cvra/VL53L0X-tof-sensor-board/tof-sensor-board.pdf

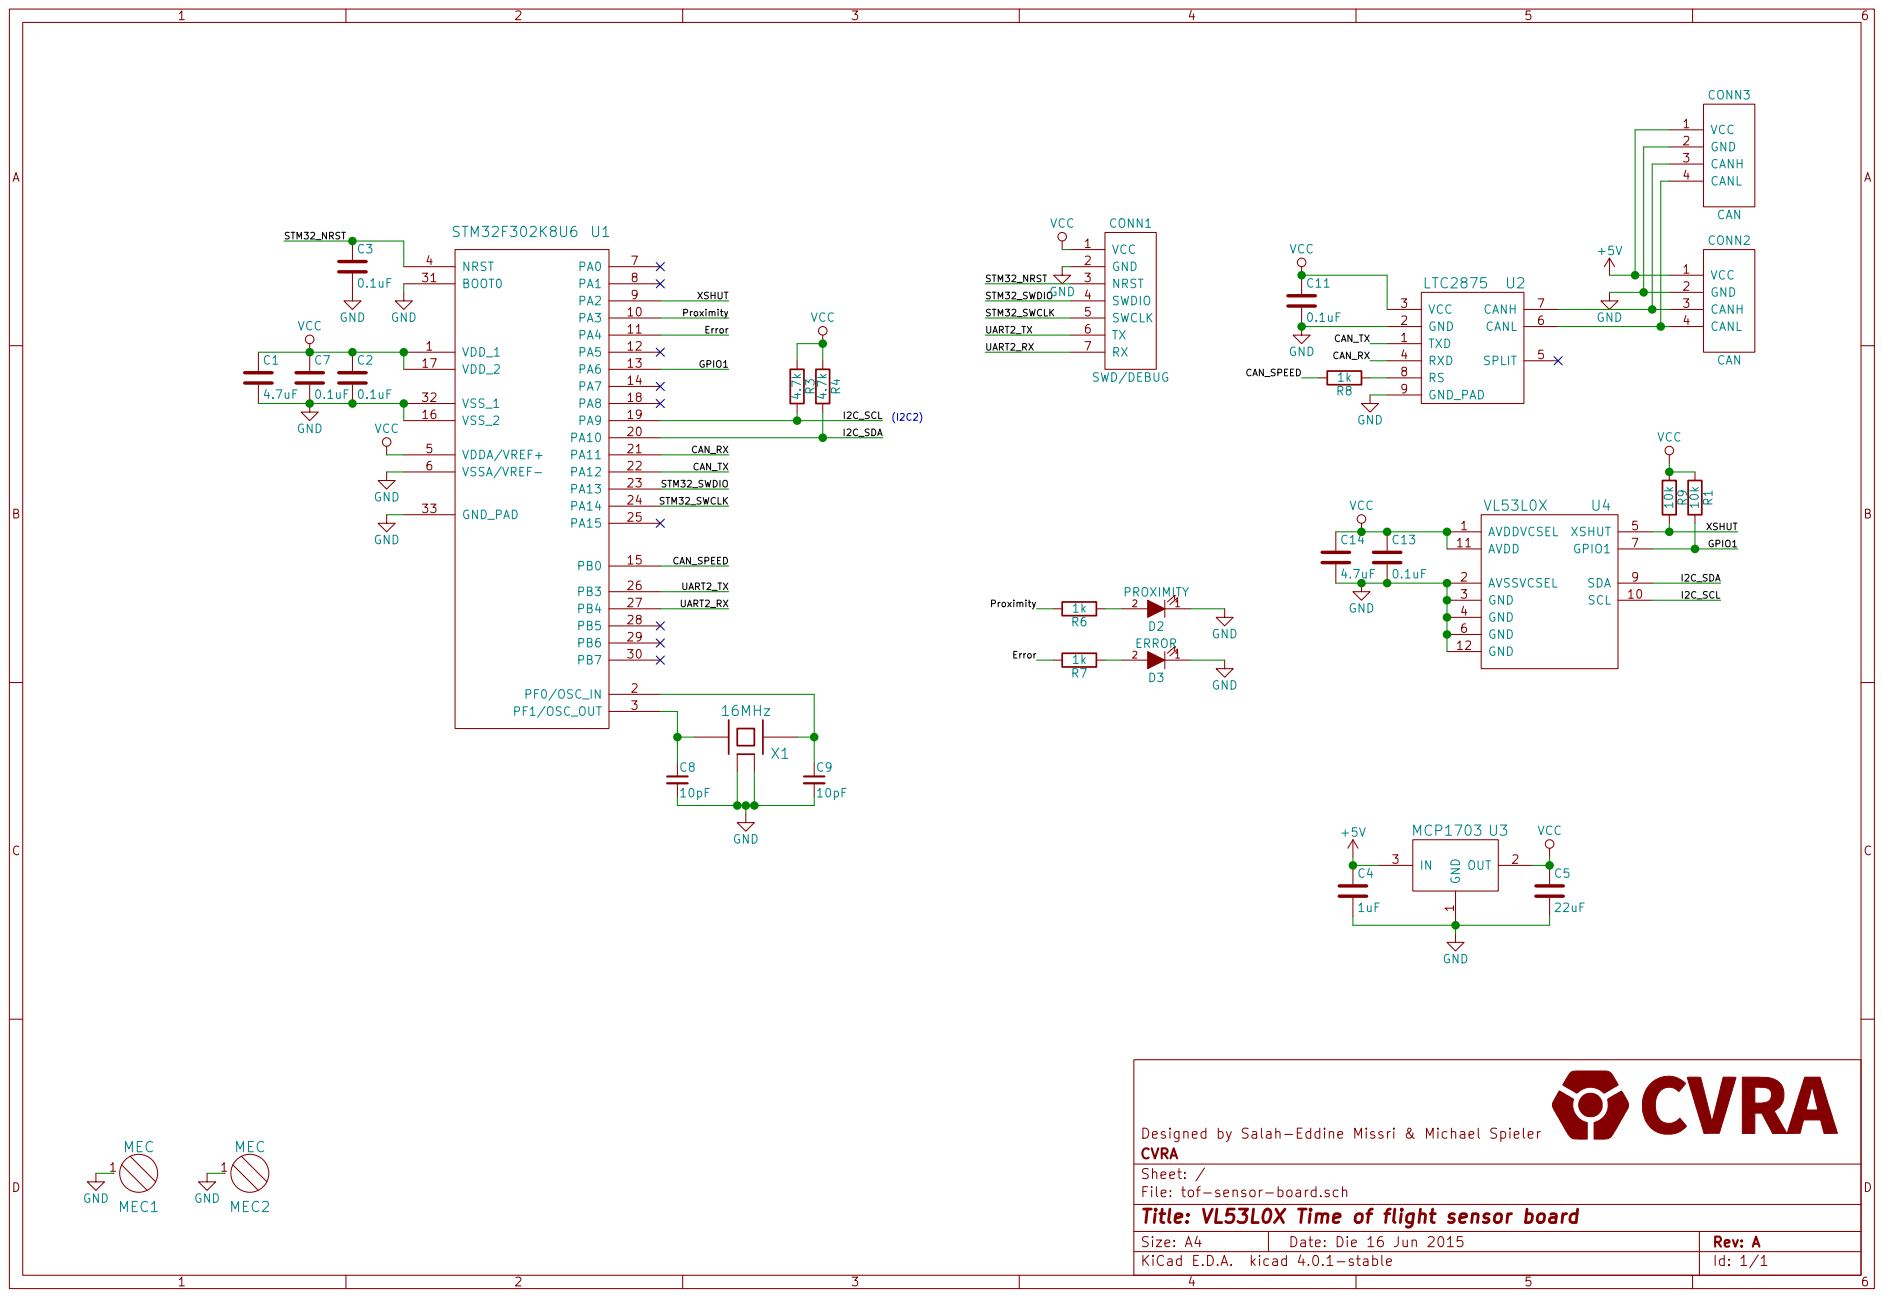
[picture p1: page 1]

Proximity Error Error Proximity

Designed by Salah-Eddine Missri & Michael Spieler C8

File: tof-sensor-board.sch Sheet: / CVRA

Id: 1/1 Title: VL53L0X Time of flight sensor board
