cvra/VL53L0X-tof-sensor-board/tof-sensor-board.kicad_pcb

## KiCad design tof-sensor-board.kicad_pcb (2016-09-06)

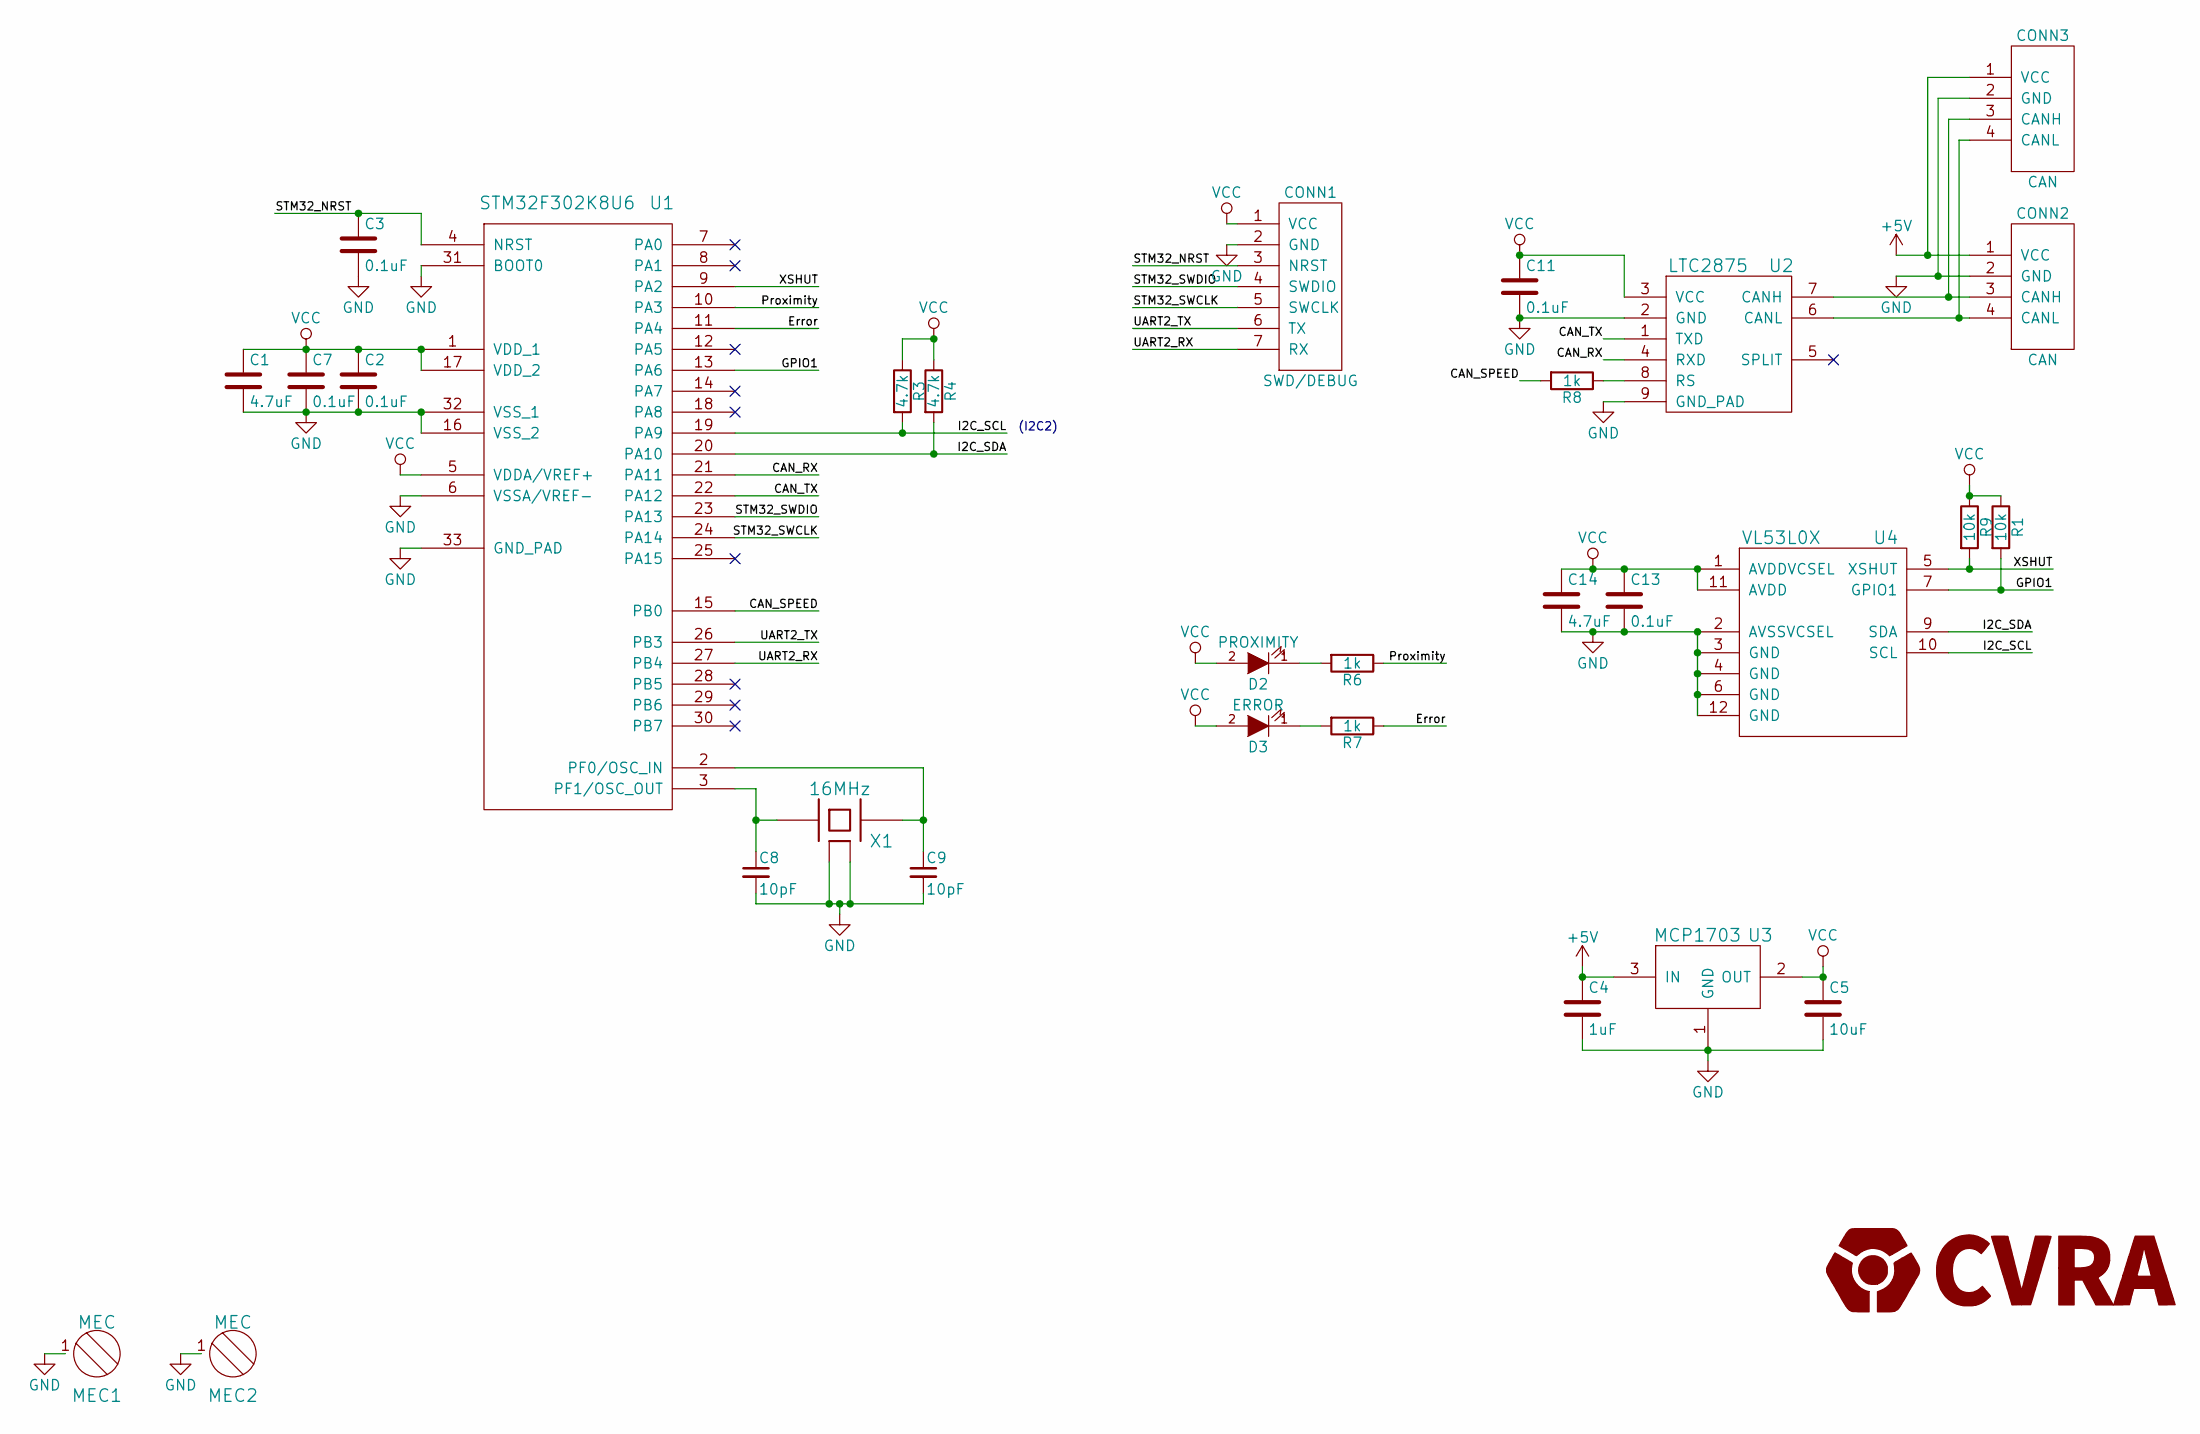
[picture p2: schematic tof-sensor-board.sch, VL53L0X Time of flight sensor board]

Parts:
C1, C14: 4.7uF; C_0603
C2, C3, C7, C11, C13: 0.1uF; C_0402
C4: 1uF; C_0603
C5: 10uF; C_0603
C8, C9: 10pF; C_0402
CONN1: SWD/DEBUG; Connector_Molex_PicoBlade_53047-0710
CONN2, CONN3: CAN; _Molex-PicoBlade-SMD-4
D2: PROXIMITY; R_0603
D3: ERROR; R_0603
MEC1, MEC2: MEC; _M2
R1, R9: 10k; R_0402
R3, R4: 4.7k; R_0402
R6, R7, R8: 1k; R_0402
U1: STM32F302K8U6; QFN-32-1EP_5x5mm_Pitch0.5mm
U2: LTC2875; DFN-8-1EP_3x3mm_Pitch0.5mm
U3: MCP1703; SOT-23
U4: VL53L0X
X1: 16MHz; _TSX-3225-SMD-XTAL

Connections:
+5V: C4.1, CONN2.1 (VCC), CONN3.1 (VCC), U3.3 (IN)
/CAN_RX: U1.21 (PA11), U2.4 (RXD)
/CAN_SPEED: R8.2, U1.15 (PB0)
/CAN_TX: U1.22 (PA12), U2.1 (TXD)
/Error: R7.1, U1.11 (PA4)
/GPIO1: R1.2, U1.13 (PA6), U4.7 (GPIO1)
/I2C_SCL: R3.2, U1.19 (PA9), U4.10 (SCL)
/I2C_SDA: R4.2, U1.20 (PA10), U4.9 (SDA)
/Proximity: R6.1, U1.10 (PA3)
/STM32_NRST: C3.1, CONN1.3 (NRST), U1.4 (NRST)
/STM32_SWCLK: CONN1.5 (SWCLK), U1.24 (PA14)
/STM32_SWDIO: CONN1.4 (SWDIO), U1.23 (PA13)
/UART2_RX: CONN1.7 (RX), U1.27 (PB4)
/UART2_TX: CONN1.6 (TX), U1.26 (PB3)
/XSHUT: R9.2, U1.9 (PA2), U4.5 (XSHUT)
GND: C1.2, C2.2, C3.2, C4.2, C5.2, C7.2, C8.2, C9.2, C11.2, C13.2, C14.2, CONN1.2 (GND), CONN2.2 (GND), CONN2.MECH (GND), CONN3.2 (GND), CONN3.MECH (GND), MEC1.1, MEC2.1, U1.6 (VSSA/VREF-), U1.16 (VSS_2), U1.31 (BOOT0), U1.32 (VSS_1), U1.33 (GND_PAD), U2.2 (GND), U2.9 (GND_PAD), U3.1 (GND), U4.2 (AVSSVCSEL), U4.3 (GND), U4.4 (GND), U4.6 (GND), U4.12 (GND), X1.2 (case), X1.4 (case)
unnamed: C8.1, U1.3 (PF1/OSC_OUT), X1.1
unnamed: C9.1, U1.2 (PF0/OSC_IN), X1.3
unnamed: CONN2.3 (CANH), CONN3.3 (CANH), U2.7 (CANH)
unnamed: CONN2.4 (CANL), CONN3.4 (CANL), U2.6 (CANL)
unnamed: D2.1 (K), R6.2
unnamed: D3.1 (K), R7.2
unnamed: R8.1, U2.8 (RS)
VCC: C1.1, C2.1, C5.1, C7.1, C11.1, C13.1, C14.1, CONN1.1 (VCC), D2.2 (A), D3.2 (A), R1.1, R3.1, R4.1, R9.1, U1.1 (VDD_1), U1.5 (VDDA/VREF+), U1.17 (VDD_2), U2.3 (VCC), U3.2 (OUT), U4.1 (AVDDVCSEL), U4.11 (AVDD)

Notes on the sheet:
(I2C2)

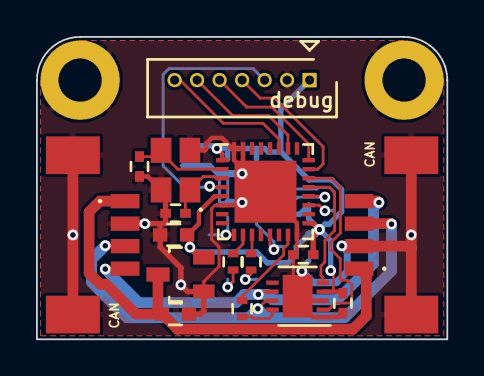
[picture p3: board tof-sensor-board.kicad_pcb from above]

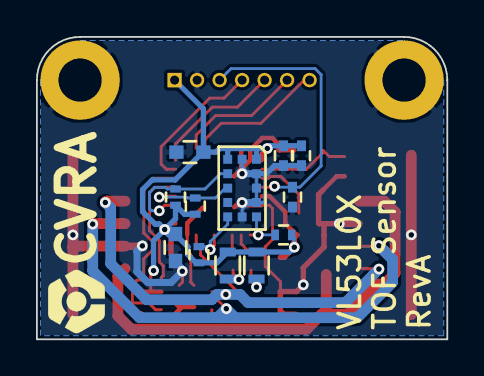
[picture p4: board tof-sensor-board.kicad_pcb from below]

Board: 2 copper layers, 22.8 x 16.8 mm, 30 parts (12 on the bottom side), 24 nets.
