cvra/VL53L0X-tof-sensor-board/(commit log)

2015-05-29 Add KiCad library
2015-06-16 Schematic (done)
    [tof-sensor-board.sch]
2015-06-16 Plot schematic to PDF
2015-06-16 Duplicate CAN connector to allow daisy chain wiring
    [tof-sensor-board.sch]
2015-07-04 Components footprints
    [tof-sensor-board.kicad_pcb]
2016-05-31 Switch to VL53L0X and QFN32 STM32f302
    [tof-sensor-board.kicad_pcb, tof-sensor-board.sch]
2016-06-06 Fix I2C connection, remove power LED
    [tof-sensor-board.sch]
2016-07-24 Start placing footprints
    [tof-sensor-board.kicad_pcb, tof-sensor-board.sch]
2016-07-24 LDO footprint, fix unconnected GND pin
    [tof-sensor-board.kicad_pcb, tof-sensor-board.sch]
2016-07-24 Place mounting holes
    [tof-sensor-board.kicad_pcb]
2016-07-25 elongated shape with connectors on same edge
    [tof-sensor-board.kicad_pcb]
2016-07-25 mounting holes on same edge
    [tof-sensor-board.kicad_pcb]
2016-08-31 routing finished
    [tof-sensor-board.kicad_pcb, tof-sensor-board.sch]
2016-08-31 set solder stop mask and solder paste clearance
    [tof-sensor-board.kicad_pcb]
2016-09-01 gerber files
    [tof-sensor-board-B.Cu.gbl, tof-sensor-board-B.Mask.gbs, tof-sensor-board-B.Paste.gbp, tof-sensor-board-B.SilkS.gbo, tof-sensor-board-Edge.Cuts.gm1, tof-sensor-board-F.Cu.gtl, tof-sensor-board-F.Mask.gts, tof-sensor-board-F.Paste.gtp]
2016-09-01 annotate sensor position
    [tof-sensor-board.kicad_pcb]
2016-09-06 Review changes
    changes from Rouven's review:
    - fix silkscreen too close to pad
    - increase CAN and 5V trace width
    - make LEDs common VCC
    - route voltage regulator 5V input through cpacitor
    - add debug connector label
    [tof-sensor-board.kicad_pcb, tof-sensor-board.sch]
